pskowronek/Lightning-camera-trigger/www/assembled/02.jpg

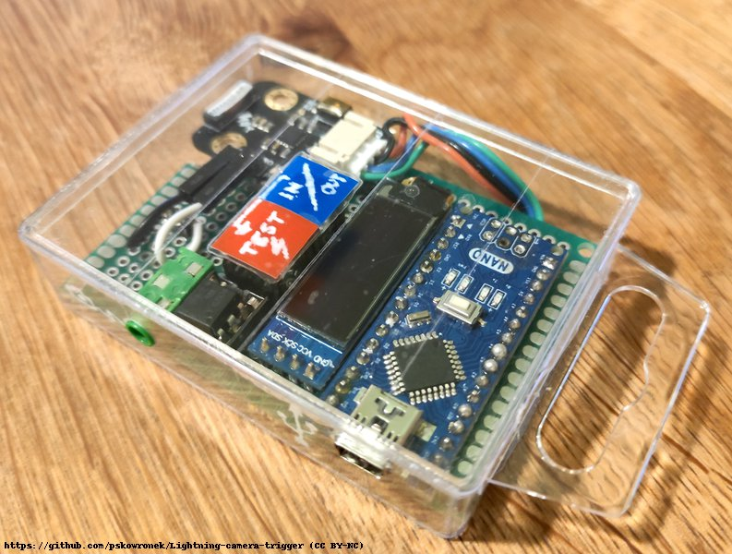
www/assembled/02.jpg
