pskowronek/Lightning-camera-trigger/www/assembled/03.jpg

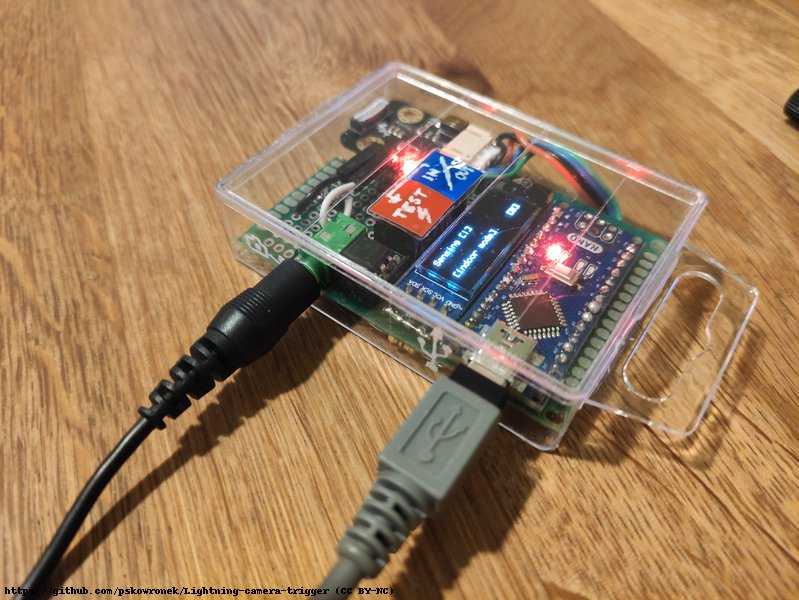
www/assembled/03.jpg
