pskowronek/Lightning-camera-trigger/www/assembled/04.jpg

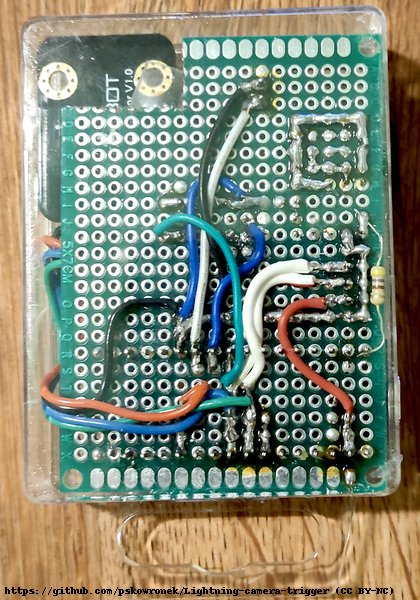
www/assembled/04.jpg
