pskowronek/Lightning-camera-trigger/www/assembled/thumbs/01.jpg

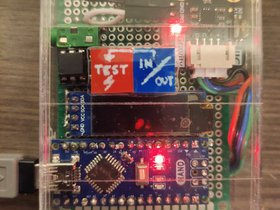
www/assembled/thumbs/01.jpg
