pskowronek/Lightning-camera-trigger/www/assembled/thumbs/04.jpg

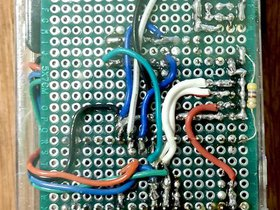
www/assembled/thumbs/04.jpg
