pskowronek/Lightning-camera-trigger/(commit log)

2020-11-30 minor bugfix for outdoors - reboot would apply changes nevertheless
    [lightningCameraTrigger.ino]
2020-12-02 Some minor fixes, typos
    [lightningCameraTrigger.ino]
2025-12-24 Update to 2025 version of Arduino
2025-12-24 Added useful link for calibration and settings
